AdithyaKesanJayakanth/PLE-SBS/video/script.md

# PLE-SBS in one minute

**Video script.** First person, in Adithya's voice. One continuous narration over eight scenes.

- Runtime 56 s · 1920×1080 · 30 fps · narration 194 words
- Narrator: ElevenLabs "Eric (calm, composed American male)", eleven_multilingual_v2, speed 1.2
- Built by `video/make_video.py`; this file is written by the same run, so the times are the ones in the video.

## Logline

A student who once designed roller-coaster tracks around what a human body can take asks how a launch crew gets down from a fuelled rocket, builds a validated simulator to find out, breaks his own first design, and fixes it with a switch yard: one wire, and a braked bay for every pod.

## Script

### 1. Title  ·  0.0 to 2.0 s

**Visual.** Black fades up to the PLE-SBS wordmark on the dark simulator background; a thin blue rule draws itself; subtitle and name fade in.

**On screen.** PLE-SBS  /  A way down from a fuelled rocket, told by the student who designed it  /  Adithya Kesan Jayakanth · Grade 12, Chennai

**Narration.** None; the first line begins as the title settles.

### 2. The roller-coaster paper  ·  2.0 to 6.5 s

**Visual.** A schematic coaster track. An orange car rides it left to right while, below, the rider's g is traced live in orange against a red 'limit' line. The two peaks of g sit just under the limit.

**On screen.** My earlier paper · roller-coaster track design under human g and jerk limits  /  The ride is designed around the forces on the rider  /  A track is a machine for giving people forces safely: the thrill and the limit are the same number.

**Narration (1.0 to 6.4 s).**

> Last year I designed roller-coaster tracks around the limits of the human body. The thrill and the limit turned out to be the same number.

### 3. The visit to ISRO, and the question  ·  6.5 to 14.2 s

**Visual.** Zoom on the launch tower from the simulator's side view: rocket, tower, the crew access level at 42 m, three waiting pods, the fireball outline. An orange arrow drops from the access level to the ground and the question appears. Three facts slide in on the right.

**On screen.** A visit to ISRO · the question  /  how do they get down?  /  40 to 115 m above a fully fuelled rocket  /  120 s: the Shuttle-era window to be clear  /  no power: it must work when everything else has failed  /  Minutes before launch, people are working high on the tower

**Narration (6.6 to 14.1 s).**

> Then a visit to ISRO raised a different question. A crew works a hundred metres up a tower, beside a fuelled rocket. If the alarm sounds, how do they get down?

### 4. What exists  ·  14.2 to 19.8 s

**Visual.** A white card with Figure 3 of the paper: pod speed along the wire for the Shuttle-era and Artemis-era systems at LC-39B, against NASA's reported speeds.

**On screen.** What exists · NASA's slidewire baskets, Shuttle era and Artemis era  /  Each system was engineered for one pad  /  Model against the reported basket speeds, with no tuning: the Shuttle peak comes out within 3 %.

**Narration (14.3 to 19.7 s).**

> NASA's slidewire baskets are each built for one pad. I wanted a method for any rocket, on any tower.

### 5. The model and the simulator  ·  19.8 to 29.3 s

**Visual.** First a white card with Figure 1: TNT equivalent, blast distance and fireball-heat distance for five vehicles, with every wire ending inside the hazard zone. Then the live simulator: the sagging wire from the 42 m tower to the pit 300 m away, the clock running, three pods releasing and riding down one after another.

**On screen.** The hazard model · propellant to TNT equivalent to blast and fireball to a safe distance  /  One rule for any rocket: the propellant load sets the safe distance  /  The simulator · a taut string with every pod's weight on it · 16 unit tests, one physics file  /  Every pod's weight changes the slope under every other pod

**Narration (19.9 to 29.2 s).**

> So I turned propellant into TNT equivalent to size the safe distance, modelled the sagging wire, and built a simulator. Untuned, it matched the Shuttle basket's speed within three percent.

### 6. Running it until it broke  ·  29.3 to 36.9 s

**Visual.** Table 3 appears row by row: D0 to D4, with failing runs in red turning to green and the worst stop falling from 16.4 g to 1.4 g. Then a white card with Figure 4, the sizing band for any pad, with the straight-line rule across it.

**On screen.** Running it until it broke · nine people, danger level 4, both wind corners, 1,000 Monte Carlo runs  /  My first design, a copy of Artemis on a low pad, failed 93 % of runs  /  A sizing rule for any pad · passive braking works only in a narrow band  /  Span ≈ 100 m + 4 × the crew access height

**Narration (29.4 to 36.8 s).**

> Then I ran it until it broke. Copying Artemis onto a low pad failed ninety-three percent of runs. Geometry fixed it, and gave a sizing rule for any pad.

### 7. The switch yard  ·  36.9 to 48.5 s

**Visual.** Plan view of the receiving end, drawn from the model's trajectories. The wire comes in from the left past the block marker to the self-indexing points; three bays fan out, each with a hatched 60 m magnetic brake, a drag-chain bed and an orange net; the bunker stands at the right. Pods arrive about nine seconds apart; the points flip to the next bay once each pod has cleared; each pod slows in its bay and stops, and its three occupants walk to the bunker.

**On screen.** My add-on · one wire, a switch yard and a bay for every pod  /  Self-indexing points send each pod into its own braked bay  /  About 8 s between pods · 1.4 g with a failed brake · no power

**Narration (37.0 to 48.4 s).**

> My add-on is a switch yard. Self-indexing points send each pod, from one shared wire, into its own braked bay. Eight seconds between pods, one point four g with a failed brake, and no power.

### 8. What I learned, and the close  ·  48.5 to 56.3 s

**Visual.** Three lessons appear in turn, with the Monte Carlo histogram and the sensitivity chart on a small card. Then the end card: wordmark, name, school, mentor and the simulator address, fading to black.

**On screen.** Design a safety system at its corners.  /  Once the hardware works, the seconds left are human.  /  Running it is how you find out.  /  PLE-SBS · Adithya Kesan Jayakanth · Grade 12, Padma Seshadri Bala Bhavan, Chennai  /  Paper, simulator and poster: adithyakesan.com/ple_sbs · Mentor: Mrs. Abitha Peter

**Narration (48.6 to 55.7 s).**

> What I learned: design a safety system at its corners. Once the hardware works, the seconds left are human. I'm Adithya, and this is PLE-SBS.

## Narration only (for recording)

1. Last year I designed roller-coaster tracks around the limits of the human body. The thrill and the limit turned out to be the same number.
2. Then a visit to ISRO raised a different question. A crew works a hundred metres up a tower, beside a fuelled rocket. If the alarm sounds, how do they get down?
3. NASA's slidewire baskets are each built for one pad. I wanted a method for any rocket, on any tower.
4. So I turned propellant into TNT equivalent to size the safe distance, modelled the sagging wire, and built a simulator. Untuned, it matched the Shuttle basket's speed within three percent.
5. Then I ran it until it broke. Copying Artemis onto a low pad failed ninety-three percent of runs. Geometry fixed it, and gave a sizing rule for any pad.
6. My add-on is a switch yard. Self-indexing points send each pod, from one shared wire, into its own braked bay. Eight seconds between pods, one point four g with a failed brake, and no power.
7. What I learned: design a safety system at its corners. Once the hardware works, the seconds left are human. I'm Adithya, and this is PLE-SBS.

## Notes

- Every pod position in scenes 5 and 7 comes from the model in `sim/core.js` (design D5, generic 42 m pad, nine people). The capsule-exit time is set to zero so all three pods are seen in sequence; with the paper's 60 s exit the third pod leaves at 90 s.
- The figures are the paper's own (10 June 2026). The roller-coaster track in scene 2 is a schematic drawn for the video, not a figure from the earlier paper.
- The launcher and pad are generic. The visit to ISRO is named only as the inspiration; no ISRO pad, vehicle or person is referred to.
- Rebuild: `.venv/bin/python video/make_video.py` with `ELEVENLABS_API_KEY` set (clips are cached, so a rebuild does not re-bill). `--quick` renders a 10 fps preview; `--script-only` rewrites this file from the cached narration without rendering.
