AdithyaKesanJayakanth/PLE-SBS/figures/fig6_final.png

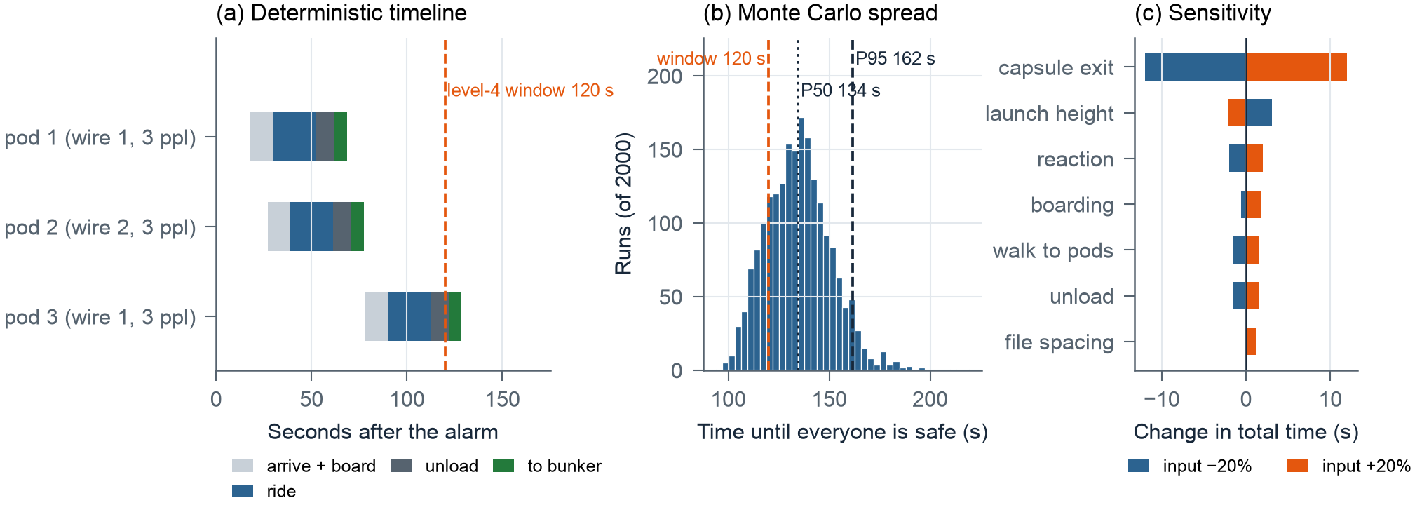
figures/fig6_final.png
