AdithyaKesanJayakanth/PLE-SBS/video/PLESBS_60s_still.png

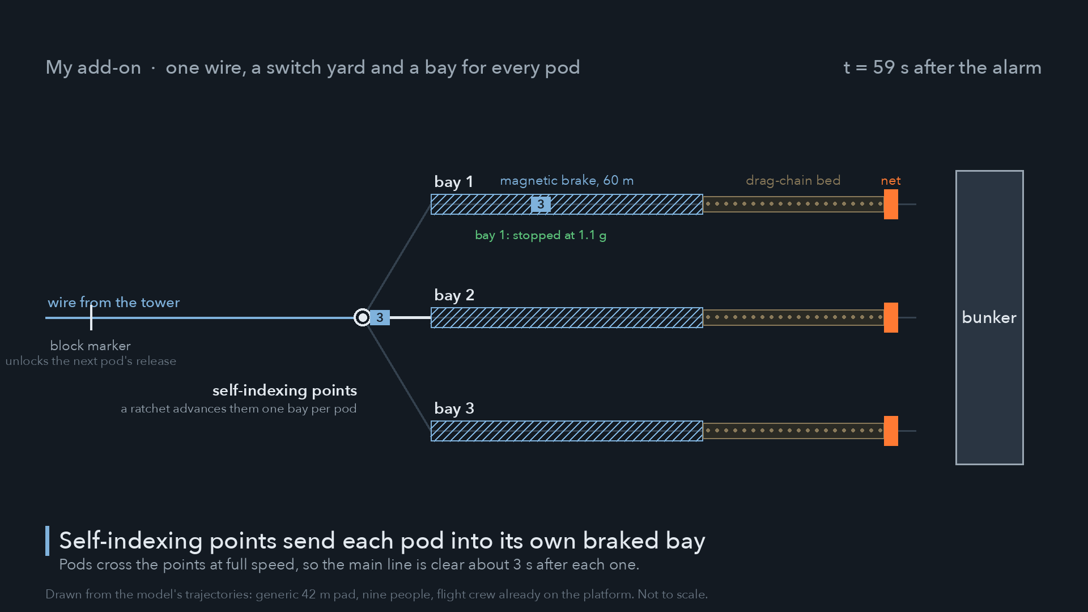
video/PLESBS_60s_still.png
