AdithyaKesanJayakanth/PLE-SBS/cad/parts_preview.png

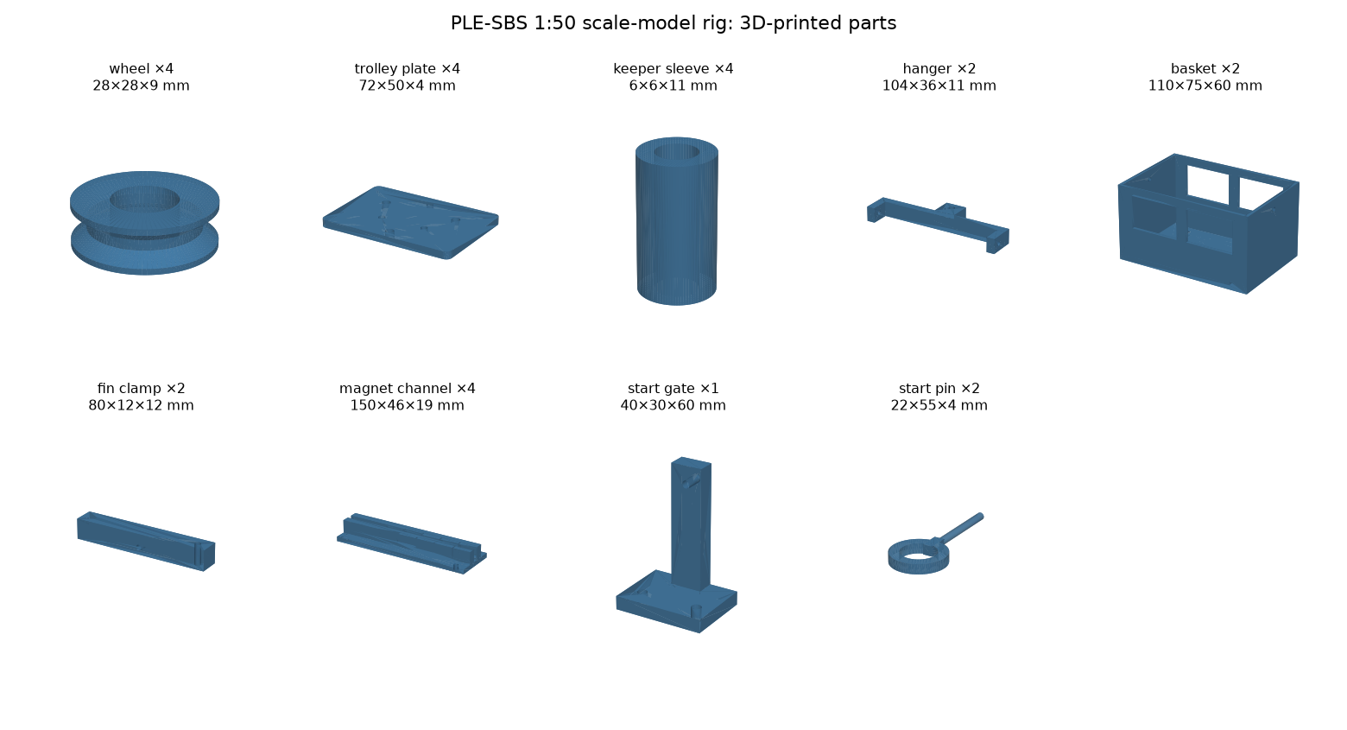
cad/parts_preview.png
