AdithyaKesanJayakanth/PLE-SBS/cad/stl/keeper_sleeve_x4.stl

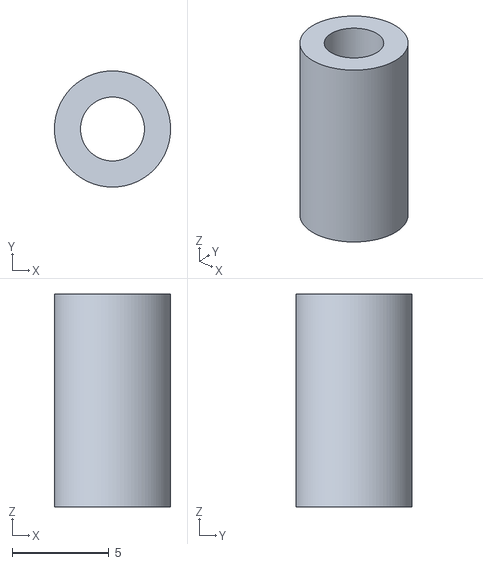
[picture p17: CAD file, 2026-05-24]
cad/stl/keeper_sleeve_x4.stl
6.00 x 6.00 x 11.0
