AdithyaKesanJayakanth/PLE-SBS/cad/stl/magnet_channel_150mm_x4.stl

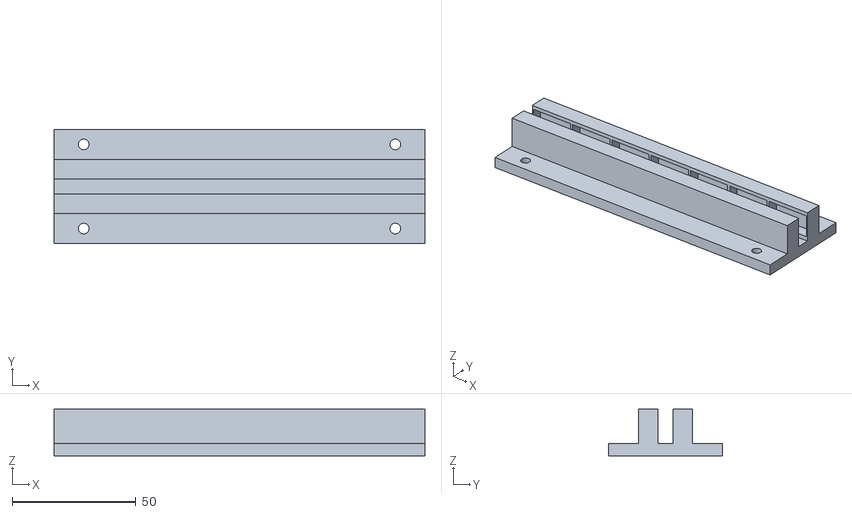
[picture p18: CAD file, 2026-05-24]
cad/stl/magnet_channel_150mm_x4.stl
150.0 x 46.0 x 19.0
