AdithyaKesanJayakanth/PLE-SBS/cad/stl/basket_x2.stl

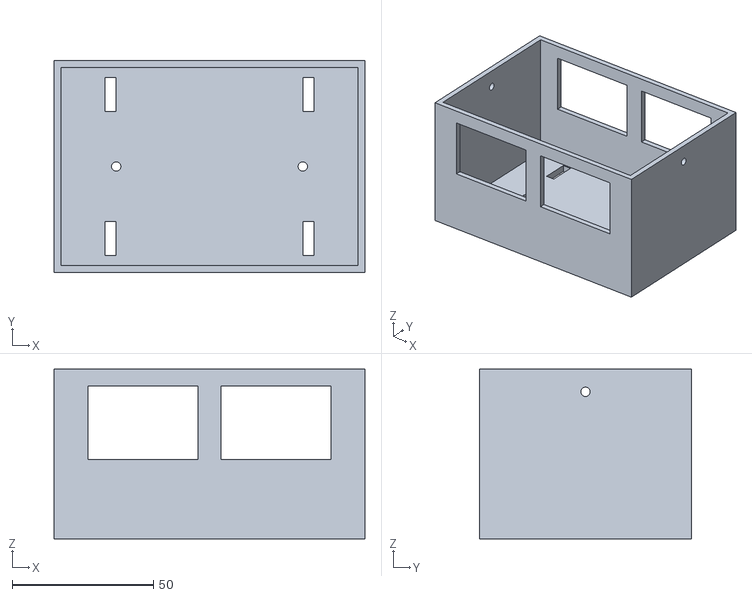
[picture p19: CAD file, 2026-05-24]
cad/stl/basket_x2.stl
110.0 x 75.0 x 60.0
