AdithyaKesanJayakanth/PLE-SBS/cad/stl/trolley_plate_x4.stl

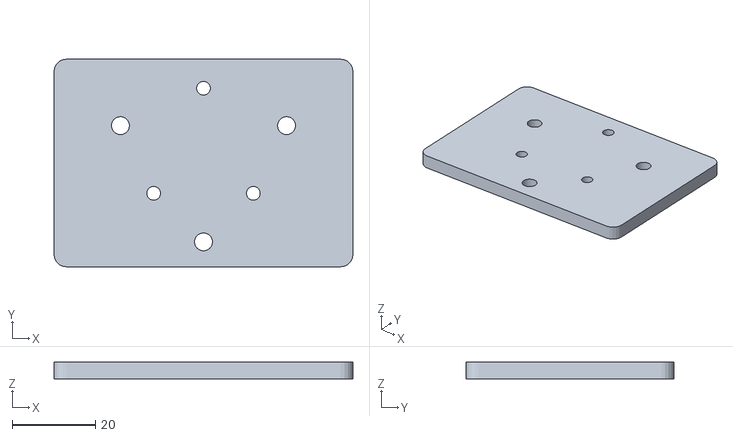
[picture p20: CAD file, 2026-05-24]
cad/stl/trolley_plate_x4.stl
72.0 x 50.0 x 4.00
