AdithyaKesanJayakanth/PLE-SBS/cad/stl/start_gate_x1.stl

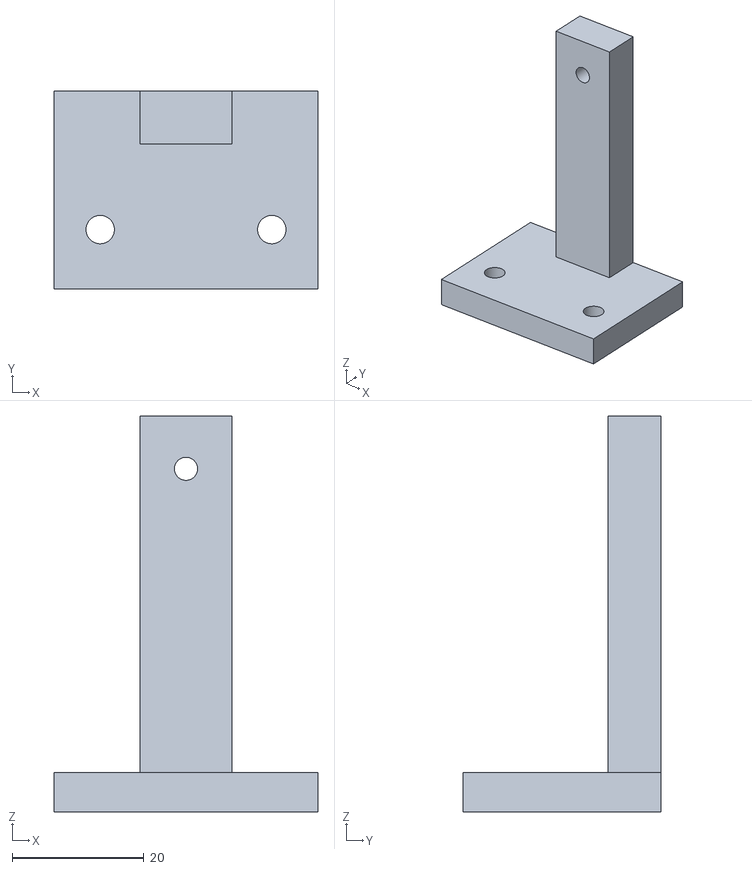
[picture p21: CAD file, 2026-05-24]
cad/stl/start_gate_x1.stl
40.0 x 30.0 x 60.0
