AdithyaKesanJayakanth/PLE-SBS/cad/stl/hanger_x2.stl

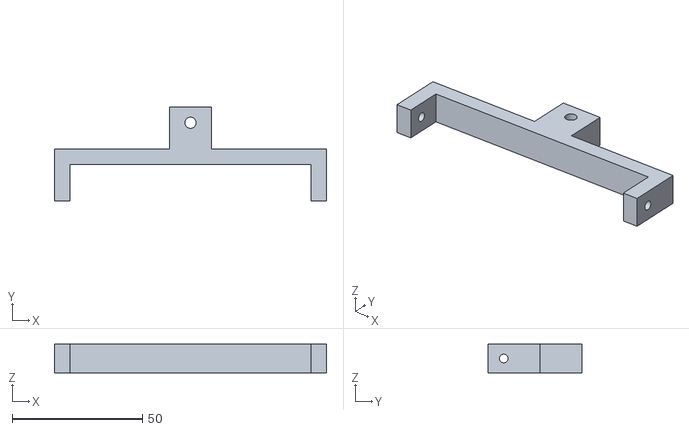
[picture p22: CAD file, 2026-05-24]
cad/stl/hanger_x2.stl
104.4 x 36.0 x 11.0
