AdithyaKesanJayakanth/PLE-SBS/cad/stl/start_pin_x2.stl

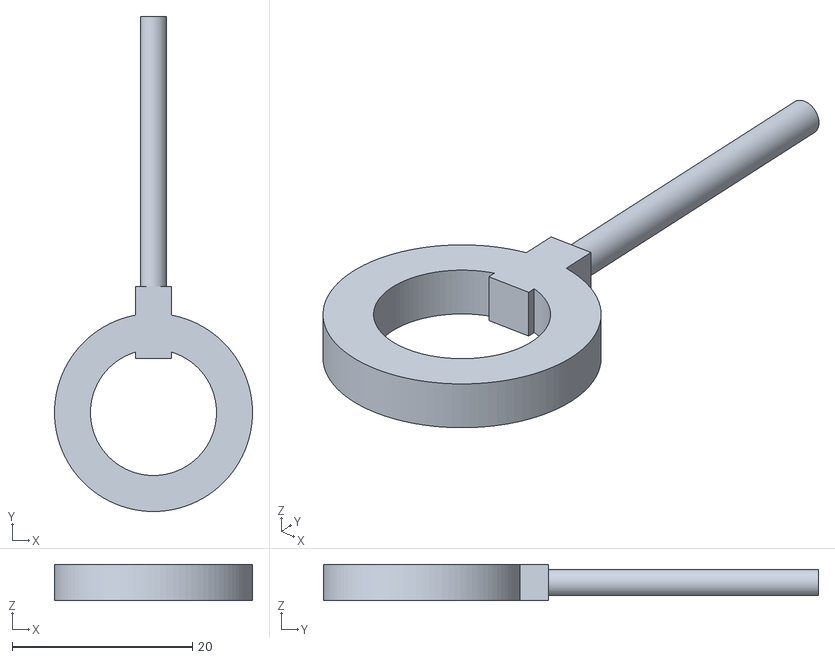
[picture p23: CAD file, 2026-05-24]
cad/stl/start_pin_x2.stl
22.0 x 55.0 x 4.00
