AdithyaKesanJayakanth/PLE-SBS/cad/stl/wheel_x4.stl

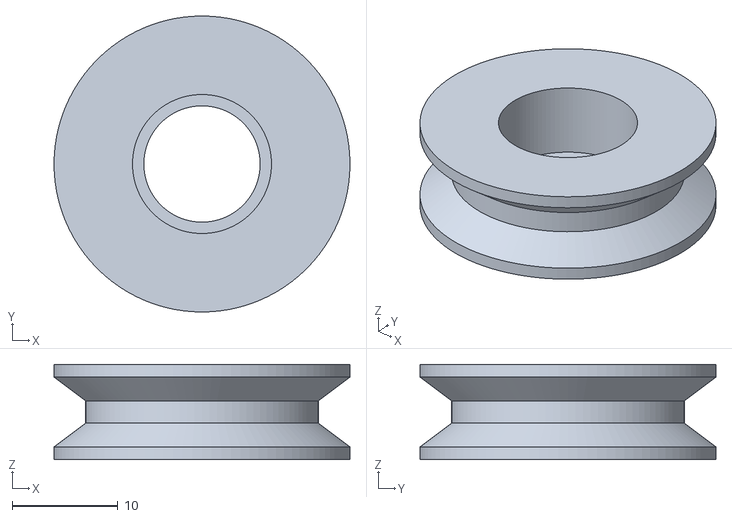
[picture p24: CAD file, 2026-05-24]
cad/stl/wheel_x4.stl
28.0 x 28.0 x 9.00
