AdithyaKesanJayakanth/PLE-SBS/cad/stl/fin_clamp_x2.stl

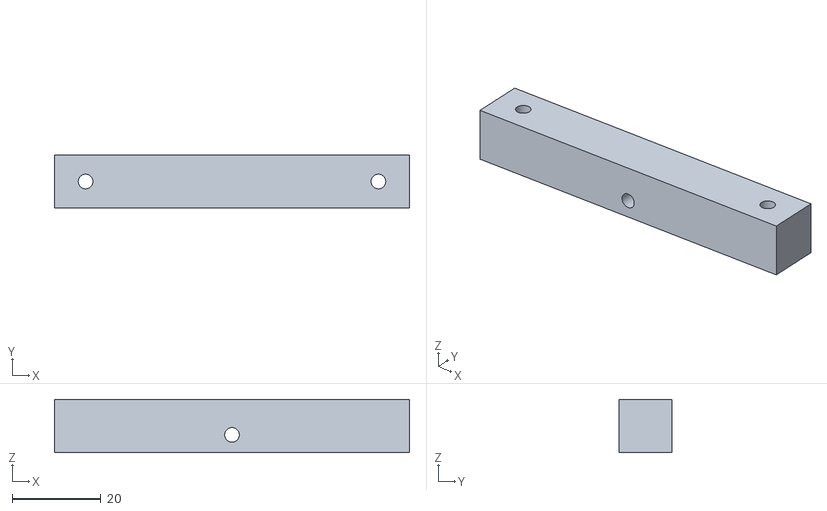
[picture p25: CAD file, 2026-05-24]
cad/stl/fin_clamp_x2.stl
80.0 x 12.0 x 12.0
