AdithyaKesanJayakanth/PLE-SBS/(commit log)

2026-05-11 Set up project: build scripts, paper template, data layout
    [scale_model.csv]
2026-05-24 Add scale-model CAD parts, drawings, BOM and test protocol
    [basket_x2.stl, fin_clamp_x2.stl, hanger_x2.stl, keeper_sleeve_x4.stl, magnet_channel_150mm_x4.stl, scale-model-bom.csv, start_gate_x1.stl, start_pin_x2.stl]
2026-06-09 Highlight my special add-on: one wire, a switch yard and a bay for every pod
2026-10-14 Research poster (A0): from the coaster paper and the ISRO visit to the switch yard
